Tslrs/NanoLink86/fpga_spartan3a/README.md

# Next186 SoC FreeDOS on Xilinx Spartan-3A Starter Kit

A port of the **Next186 SoC PC** (80186-compatible CPU, VGA, SD card, PS/2 keyboard, DDR2) to the
**Xilinx Spartan-3A Starter Kit (XC3S700A-4FGG484C)**. The board boots **FreeDOS 1.3** from a
microSD card and is controlled by the same **NanoLink86 ESP32 keyboard** used for the Tang Nano 9K
version, with **no change to the ESP32 firmware**.

<p align="center">
  Spartan-3A Starter Kit with the NanoLink86 ESP32 keyboard (top right) and the microSD SPI module (bottom right) on breadboards
</p>
<p align="center"><em>The Spartan-3A Starter Kit running the design. Top right: the ESP32 (NanoLink86 keyboard). Bottom right: the microSD SPI module. Both are wired to the board's 6-pin expansion headers.</em></p>

<p align="center">
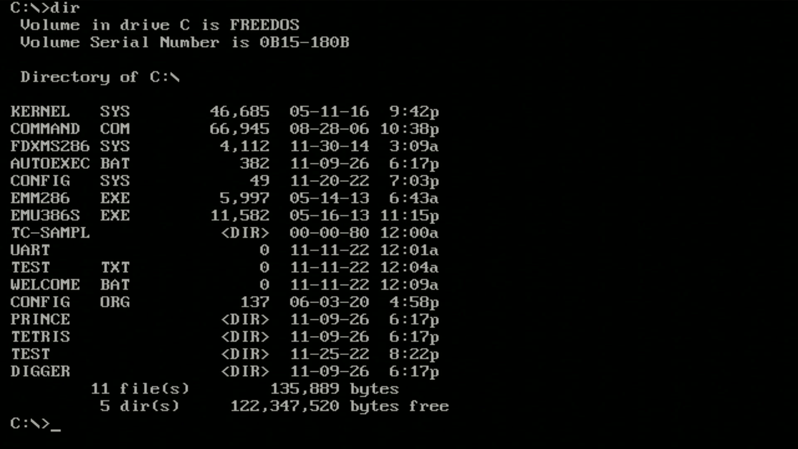
[picture p13: fpga_spartan3a/assets/spartan3a_freedos_dir.png]
FreeDOS dir listing on the Spartan-3A, captured from the VGA output
  
  Prince of Persia running on the Spartan-3A
</p>
<p align="center">
  Tetris running on the Spartan-3A
</p>

Longer videos (captured from the board's VGA output):
[Tetris](assets/videos/spartan3a_tetris_demo.mp4) and
[Prince of Persia](assets/videos/spartan3a_prince_of_persia_demo.mp4).

---

## Status

Verified on real hardware (frames captured from the board's VGA output):

| Item | Result |
| :--- | :--- |
| Boot FreeDOS 1.3 (FreeCom 0.84) from a 16 GB SDHC card | works, also after a power cycle |
| Design stored permanently in the on-board SPI flash (Atmel AT45DB161D) | works (cold-boot verified) |
| DDR2 (64 MB) memory test, 64 KB patterns | 398 passes, 0 errors |
| DOS commands from the NanoLink86 keyboard (`dir`, `echo`, `ver`, ...) | works |
| Tetris (text/graphics, colours, score) | works, controls 7/9/8/Space |
| Prince of Persia (VGA 320x200, 256 colours, arrow keys) | works |
| Digger, PS/2 mouse (second PS/2 channel) | not tested |

## Hardware

| Part | Details |
| :--- | :--- |
| Board | Digilent / Xilinx Spartan-3A Starter Kit, FPGA XC3S700A-4FGG484C (the silkscreen reads "Spartan-3A / Spartan-3AN": both kits share the same board layout, upstream targets the 3AN version) |
| CPU | Next186 (80186-compatible), clocked at 50 MHz x 4/3 = 66.7 MHz |
| Memory | 64 MB DDR2 (on-board), 8 KB BIOS RAM inside the FPGA, 8 x 256-byte cache |
| Video | 640x480 VGA, text mode and mode 13h |
| Storage | microSD in SPI mode (external SPI module, see pins below) |
| Keyboard | ESP32 NanoLink86, PS/2 clock/data (bit-banged by the ESP32) |
| Configuration | Atmel AT45DB161D SPI flash (JTAG: Platform Cable USB II) |

### Pin Assignment & Hardware Wiring

The design connects to external peripherals via the Spartan-3A Starter Kit's 6-pin expansion headers (**Pmod J18** for the microSD module and **Pmod J20** for the ESP32 keyboard).

<p align="center">
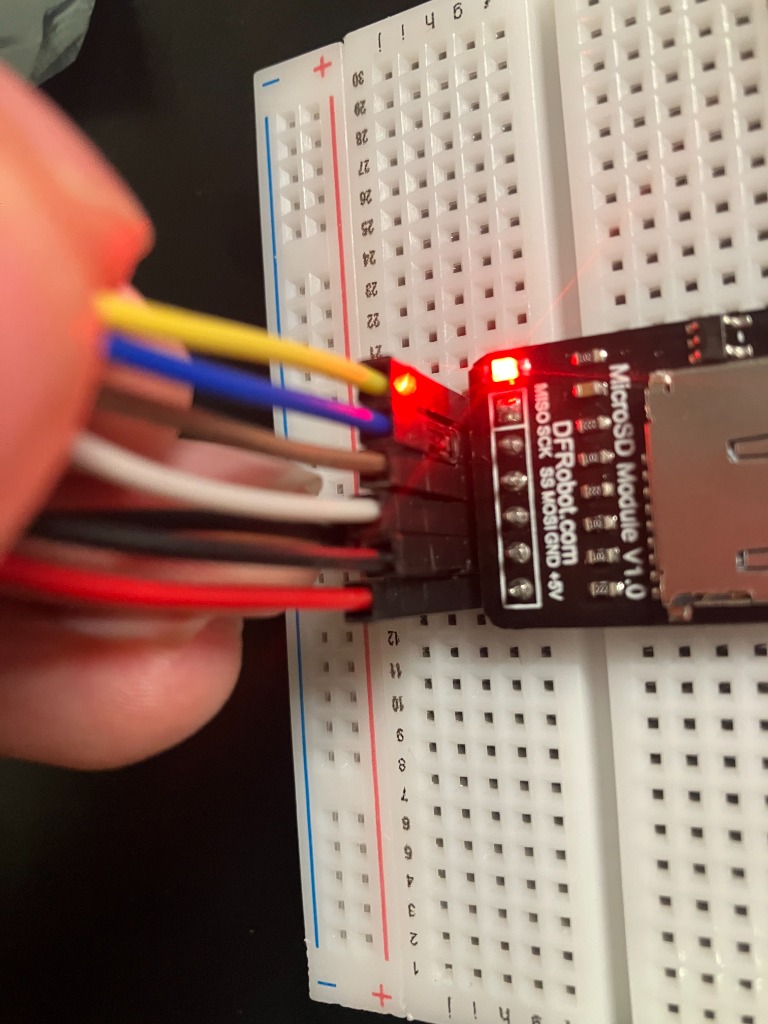
[picture p14: fpga_spartan3a/assets/spartan3a_sd_module.jpg]
DFRobot MicroSD Module V1.0 wiring
  
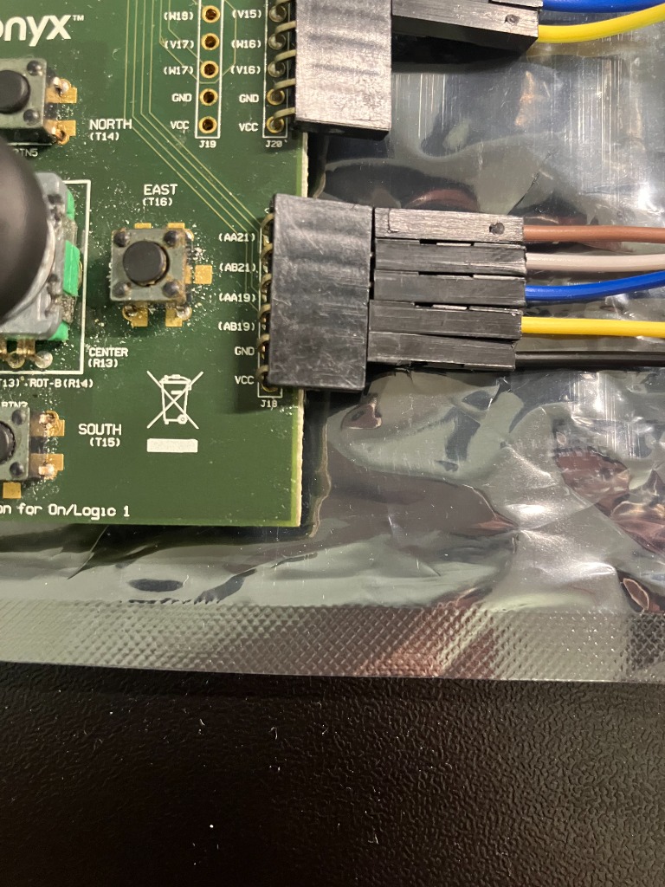
[picture p15: fpga_spartan3a/assets/spartan3a_pmod_wiring.jpg]
Spartan-3A Starter Kit Pmod J18 and J20 wiring
  
</p>
<p align="center"><em>Physical wiring: DFRobot MicroSD Module V1.0 (left) connected to Spartan-3A Pmod J18 (right), and ESP32 connected to Pmod J20.</em></p>

#### 1. MicroSD Module Wiring (Pmod J18)

The board uses an external **DFRobot MicroSD Module V1.0** operating in SPI mode connected to header **J18**:

| J18 Header Pin | FPGA Pin (`ddr_186.ucf`) | Net Name | DFRobot Module Pin | SPI Signal / Function | Reference Wire Color |
| :---: | :---: | :--- | :--- | :--- | :--- |
| **Pin 1** | `AA21` | `SD_CS` | **SS** | SPI Chip Select (Active Low) | 🟤 **Brown** |
| **Pin 2** | `AB21` | `SD_DI` | **MOSI** | Master Out / Slave In (FPGA to SD) | ⚪ **White** |
| **Pin 3** | `AA19` | `SD_CK` | **SCK** | SPI Serial Clock | 🔵 **Blue** |
| **Pin 4** | `AB19` | `SD_DO` | **MISO** | Master In / Slave Out (SD to FPGA) | 🟡 **Yellow** |
| **Pin 5** | `GND`  | `GND` | **GND** | Ground | ⚫ **Black** |
| — | — | `VCC` | **+5V** | Module Power Supply (+5V rail / VCC) | 🔴 **Red** |

> [!NOTE]
> The DFRobot MicroSD Module V1.0 includes an on-board 3.3V LDO regulator and level shifting circuitry. Connect its **+5V** pin (Red wire) to a 5V power rail (or VCC) and **GND** to common ground. When powered, the on-board red LED lights up.

#### 2. ESP32 Keyboard Connection (Pmod J20)

The ESP32 runs the exact same firmware as the Tang Nano 9K version (`esp32/main.py` or `esp32/esp32_wifi.py`). It bit-bangs PS/2 scan code set 2 directly to header **J20**:

| J20 Header Pin | FPGA Pin (`ddr_186.ucf`) | Net Name | ESP32 Pin | Function | Reference Wire Color |
| :---: | :---: | :--- | :--- | :--- | :--- |
| **Pin 1** | `V14` | `PS2_CLK1` | **GPIO 18** | Bit-banged PS/2 Clock | 🔵 **Blue** |
| **Pin 2** | `V15` | `PS2_DATA1` | **GPIO 19** | Bit-banged PS/2 Data | 🟡 **Yellow** |
| **Pin 5** | `GND` | `GND` | **GND** | Common Ground | Common GND |

The BIOS in this design expects scan code set 1, so `KB_8042.v` translates set 2 to set 1 inside the FPGA. That is why the ESP32 firmware needs zero modification.

#### 3. Other Board I/O

| Signal | FPGA Pin | Description |
| :--- | :---: | :--- |
| `PS2_CLK2` / `PS2_DATA2` | `W12` / `V11` | Second PS/2 channel (mouse), routed to the on-board female PS/2 jack |
| `sys_clk_in` / `CLK_50MHZ` | `V12` / `E12` | 133 MHz oscillator and on-board 50 MHz clock |
| `VGA_R[3:0]`, `VGA_G[3:0]`, `VGA_B[3:0]` | On-board | 12-bit DAC routed to the on-board DB15 VGA connector |
| `VGA_HSYNC` / `VGA_VSYNC` | `C11` / `B11` | VGA synchronization signals |

---

## Quick start

### 1. Prepare the SD card

Use the same FreeDOS image as the Tang Nano version (`sdcard/FDOS-128M-with-games.zip`), written
to the card. The BIOS lives inside the FPGA, so **nothing has to be written to the last 8 KB of the
card** (the upstream design needs that, this one does not).

### 2. Load the design

Temporary (lost at power-off), with Xilinx iMPACT:

```
setMode -bs
setCable -port auto
Identify -inferir
identifyMPM
assignFile -p 1 -file bitstreams/next186_spartan3a_freedos.bit
Program -p 1
quit
```

Permanent, into the SPI flash of the board (`tools`: see `bios/spi_prog.cmd`):

```
setMode -bs
setCable -port auto
Identify -inferir
identifyMPM
attachflash -position 1 -spi "AT45DB161D"
assignfiletoattachedflash -position 1 -file bitstreams/next186_spartan3a_flash_AT45DB161D.mcs
Program -p 1 -dataWidth 1 -spionly -e -v -loadfpga
quit
```

The flash is an **Atmel AT45DB161D** (JEDEC ID `1F 26 00`). Selecting another flash type (for
example `M25P16`) fails with `ID Check failed`. After programming, power-cycle the board: FreeDOS
should start by itself.

### 3. Type on it

Use the NanoLink86 web controller / relay as on the Tang Nano. For a quick test from a computer,
`tools/ws_type.py <PIN> 'dir\r'` sends text through the relay (`{LEFT}{RIGHT}{UP}{DOWN}` are
arrow keys). Known quirk: the first command typed right after a boot is sometimes corrupted; send
an Enter first.

---

## What differs from the upstream design

Upstream: <https://github.com/tmatsuya/next186_soc_pc> (commit `d59aa2b`, Spartan-3AN Starter Kit),
itself based on the Next186 SoC PC by **Nicolae Dumitrache** (OpenCores).

The CPU, the DDR2 controller, the cache, the VGA, the timers and the BIOS are **unchanged**. Changes:

1. **`src/ddr_186.v`**: BIOS RAM inside the FPGA (new `src/bios_ram.v`) instead of loading the BIOS
   from the SD card; SD card through a hardware SPI byte serializer; and a bug fix (line 440).
2. **`src/KB_8042.v`**: scan code set 2 to set 1 translation and a non-inhibited clock for the ESP32.
3. **`src/ddr_186.ucf`**: new pins for PS/2 and SD.
4. **BIOS**: 69 of 8192 bytes patched (0.8 %), applied inside the bitstream, original `.com` untouched.

Full details and the exact diffs are in [`docs/DIFF_VS_UPSTREAM.md`](docs/DIFF_VS_UPSTREAM.md) and
[`docs/patches/`](docs/patches/).

### The bug fix

The read-data mux selector for the BIOS RAM was updated on every clock:

```verilog
always @(posedge clk_cpu) bios_cs_d <= bios_cs;          // wrong
always @(posedge clk_cpu) if(CE) bios_cs_d <= bios_cs;   // fixed (ddr_186.v line 440)
```

On a cache miss the CPU is stalled (`CE = 0`), the selector moved on, and the CPU read a wrong
word. This looked like a DDR2 read-back problem for a long time; it was not (DDR2 and cache are
correct: 398 passes of a 64 KB memory test, 0 errors after the fix).

---

## Repository layout

```
fpga_spartan3a/
├── README.md
├── src/          Verilog + ISE 14.7 project (ddr_186.xise), cores, MIG DDR2, Next186 CPU
├── bios/         original BIOS, patched BIOS (8 KB), patch script, two small stubs
├── bitstreams/   ready-to-load .bit and SPI flash .mcs
├── tools/        ws_type.py (type through the relay), rec.py / cap.py (video capture)
├── docs/         DIFF_VS_UPSTREAM.md and unified diffs against upstream
└── assets/       screenshots and GIFs
```

### Building

Open `src/ddr_186.xise` in **Xilinx ISE 14.7** (device `xc3s700a`, package `fg484`, speed `-4`).
`src/bios0.hex ... bios3.hex` are generated from `bios/BIOS_Next186_spartan3a_patched.bin`
(byte lane `n` = bytes `4*i + n`), so a normal build contains the patched BIOS.
> The shipped `.bit` was produced by patching the BIOS into the BRAM initial values of an
> already placed-and-routed design (`xdl` -> `ncd` -> `bitgen`, see `bios/patch_gen.py`), which takes
> about a minute instead of a full 25-minute ISE run. A full build from `src/` has not been
> repeated with the regenerated `.hex` files.

ISE reports a small negative setup slack (about -1 ns) on the 133 MHz and 25 MHz clock domains. It
was not observed to cause problems (memory test and the games run correctly).

---

## How it was verified (capture card + Claude)

Like the Tang Nano version, the work was done in a hardware loop with an AI assistant and no lab
instruments: the board's **VGA output was plugged into a USB video capture card** (MacroSilicon
`534D:2109`), and **Claude** (Anthropic, through Claude Code) grabbed frames with OpenCV
(`tools/cap.py`), read what the FPGA was displaying, wrote a new test program in x86 assembly,
patched it into the bitstream, flashed it over JTAG, and looked at the next frame.

That loop was used to:

* run memory tests and show their result as text on screen;
* print SD card responses (CMD0/CMD8/ACMD41, OCR, CSD, partition table) as hex on screen, which
  showed a wrong BIOS patch (only the first byte of each SD command was being sent);
* confirm the FreeDOS boot, keyboard input and the games, and record the demo videos (`tools/rec.py`).

Toolchain: Xilinx ISE 14.7 inside an Ubuntu 14.04 VM (UTM on an Apple-silicon Mac), Xilinx
Platform Cable USB II, iMPACT in batch mode.

## Credits and license

* **Next186 SoC PC**: Nicolae Dumitrache (OpenCores, <http://opencores.org/project,next186>).
* **Spartan-3AN port used as the starting point**: tmatsuya (<https://github.com/tmatsuya/next186_soc_pc>).
* **NanoLink86 ESP32 keyboard and relay**: Tslrs (this repository).
* **Spartan-3A adaptation**: Tslrs, developed with AI assistance (Claude by Anthropic; an earlier
  session with another AI assistant produced the first experimental test code).

The Verilog files derived from Next186 keep their original copyright headers (GNU LGPL 2.1 or
later). Provided "as is", without warranty; wire and flash hardware at your own risk.
