Tslrs/NanoLink86/GITHUB_PROFILE_README.md

### Hi there, I'm Tslrs 👋

<p align="center">
  
</p>

```yaml
brand: Tslrs
engineer: Nikolaos Tsalaris
affiliation: Electrical & Computer Engineering, University of Western Macedonia (UOWM)
interests: [FPGA SoC Design, Embedded Systems, IoT & Telecommunications, Hardware-in-the-Loop]
location: Greece
status: Building bare-metal SoCs & open-source hardware
```

---

### 🚀 About Tslrs

- 🎓 **ECE Student** at the **University of Western Macedonia** (Kozani, Greece).
- ⚡ **FPGA & SoC Design**: Porting retro and modern x86/RISC architectures onto FPGA silicon (Xilinx Spartan-3A, Gowin Tang Nano 9K).
- 📡 **IoT & Telecommunications**: Designing long-range, low-power telemetry systems (LoRaWAN on Helium Network, ESP32, cellular IoT).
- 🔬 **Hardware-in-the-Loop & AI**: Automating silicon verification using multimodal video stream feedback and AI co-design loops.

---

### 🛠️ Tech Stack & Hardware Tools

<p align="left">
  <!-- Hardware & FPGA -->
  
  
  
  
  <br/>
  <!-- Embedded & IoT -->
  
  
  
  
  
</p>

---

### 🌟 Featured Projects

| Project | Description | Silicon / Tech |
| :--- | :--- | :--- |
| 🕹️ [**NanoLink86**](https://github.com/Tslrs/NanoLink86) | Bare-metal **FreeDOS 1.3** running on a Next186 (80186 PC) SoC. Controlled wirelessly via modern web browser & ESP32 PS/2 relay. Cross-ported to **Gowin Tang Nano 9K** and **Xilinx Spartan-3A Starter Kit** with DDR2 memory and SPI MicroSD storage. | `Verilog` `x86 SoC` `DDR2` `ESP32` `FreeDOS` |
| 🌊 [**River-Monitor-LoRaWAN**](https://github.com/Tslrs/River-Monitor-LoRaWAN-Showcase) | Solar-ready IoT river monitoring station with real-time telemetry over the **LoRaWAN Helium Network** and cloud dashboard integration. | `ESP32` `LoRaWAN` `Helium` `Low-Power` |

---

### 📊 GitHub Activity & Stats

<p align="center">
  
  
</p>

---

<p align="center">
  <em><strong>Tslrs</strong> · Building bridging systems between physical silicon and the modern web.</em>
</p>
