Tslrs/NanoLink86/PROPOSAL_PITCH_DASYGENIS.txt

================================================================================
          ΠΡΟΤΑΣΗ ΚΑΙΝΟΤΟΜΙΑΣ ΓΙΑ ΣΥΝΑΝΤΗΣΗ ΜΕ ΤΟΝ ΚΑΘΗΓΗΤΗ Μ. ΔΑΣΥΓΕΝΗ
     "Next-Gen AI-Driven Universal Toolchain for FPGA Synthesis & Programming"
================================================================================
Φοιτητής: Νικόλαος Τσαλάρης (Τμήμα ΗΜΜΥ, ΠΔΜ, ΑΜ: 2452)
Ημερομηνία Συνάντησης: Δευτέρα 16/11 ή 23/11 στις 17:00
Αποθετήριο Project: https://github.com/Tslrs/NanoLink86
================================================================================

1. Ο ΤΙΤΛΟΣ & ΤΟ ΟΡΑΜΑ ΤΗΣ ΠΡΟΤΑΣΗΣ
--------------------------------------------------------------------------------
"Εκσυγχρονισμός και Αυτοματοποίηση της Ροής Σύνθεσης & Προγραμματισμού Ετερογενών
FPGA (Xilinx/Gowin) μέσω Headless Αρχιτεκτονικής και AI Hardware-in-the-Loop"

Στόχος: Να μετατρέψουμε την πιο επίπονη διαδικασία των FPGA (βαριά εργαλεία 30GB,
αποτυχημένοι proprietary programmers, χειροκίνητο debugging) σε μια ταχύτατη,
αυτοματοποιημένη ροή που ελέγχεται ακόμα και μέσω φυσικής γλώσσας (AI Agents).

2. ΤΑ 3 ΠΡΑΓΜΑΤΙΚΑ ΠΡΟΒΛΗΜΑΤΑ ΠΟΥ ΛΥΝΟΥΜΕ (THE BOTTLENECK)
--------------------------------------------------------------------------------
1. Το Πρόβλημα της Σύνθεσης (Synthesis Bloat):
   - Εργαλεία όπως το Xilinx ISE 14.7 είναι κλειδωμένα σε λειτουργικά του 2012
     (Ubuntu 14.04 / Win7), απαιτώντας τεράστια Virtual Machines 20-30 GB.
   - Σε σύγχρονα Mac (Apple Silicon ARM64) ή νέα laptops, η εκτέλεση είναι αργή
     και μη παραγωγική.

2. Το Πρόβλημα του Προγραμματισμού (Proprietary JTAG Lock-in):
   - Οι επίσημοι προγραμματιστές (όπως ο Xilinx Platform Cable USB) βασίζονται
     σε κλειστούς kernel drivers και δυναμικό re-enumeration του Cypress FX2 chip,
     που αποτυγχάνει συστηματικά σε USB passthrough σε VMs.

3. Το Πρόβλημα της Επαλήθευσης (Manual Hardware Debugging):
   - Για να δει ο μηχανικός αν δουλεύει ένα SoC στο FPGA, κάθεται με τις ώρες μπροστά
     σε οθόνες, πληκτρολόγια και παλμογράφους δοκιμάζοντας χειροκίνητα.

3. ΟΙ 3 ΠΥΛΩΝΕΣ ΤΗΣ ΚΑΙΝΟΤΟΜΙΑΣ ΜΑΣ (Η ΛΥΣΗ)
--------------------------------------------------------------------------------

ΠΥΛΩΝΑΣ Α: ΚΑΙΝΟΤΟΜΙΑ ΣΤΟ SYNTHESIS (Headless & BRAM Instant Patching)
---------------------------------------------------------------------
* Αντί για βαριά γραφικά περιβάλλοντα (GUIs), η σύνθεση διαχωρίζεται:
  α) Remote Headless Build Server (στον server του εργαστηρίου):
     Ο φοιτητής γράφει Verilog στο laptop του (VS Code / AI). Με ένα click ή εντολή,
     το project στέλνεται στον build server, συντίθεται αθόρυβα μέσω CLI scripts
     (xst, map, par, bitgen) και επιστρέφει το έτοιμο .bit σε 2 λεπτά!
  β) Native Open-Source Synthesis (για νέα FPGA όπως Tang Nano 9K / Gowin):
     Εκτέλεση Yosys + nextpnr 100% native στο Mac/Linux σε δευτερόλεπτα.
  γ) Instant BRAM Patching (Το δικό μας μυστικό):
     Όταν αλλάζει κώδικας λογισμικού, BIOS ή microcode, δεν περιμένουμε 25 λεπτά
     για σύνθεση! Ένα script ενημερώνει απευθείας τα Block RAM initial values του
     bitstream σε 0.5 δευτερόλεπτο!

ΠΥΛΩΝΑΣ Β: ΚΑΙΝΟΤΟΜΙΑ ΣΤΟ PROGRAMMING (Universal Native Open-JTAG)
-----------------------------------------------------------------
* Καταργούμε την εξάρτηση από τους προβληματικούς proprietary programmers:
  α) Χρησιμοποιούμε Universal Open-Source εργαλεία (openFPGALoader, xc3sprog)
     που τρέχουν απευθείας σε macOS και Linux χωρίς κανένα driver πυρήνα.
  β) Universal Hardware: Χρήση φθηνών FTDI interfaces (FT2232H / Digilent HS2)
     ή ενός Raspberry Pi Pico ($4) με DirtyJTAG.
  γ) Μία ενιαία εντολή προγραμματίζει τόσο το σύγχρονο Gowin Tang Nano 9K όσο
     και την κλασική Xilinx Spartan-3A και τη μόνιμη SPI Flash!

ΠΥΛΩΝΑΣ Γ: ΤΟ ΑΠΟΛΥΤΟ HIT -> AI HARDWARE-IN-THE-LOOP (MCP & Video Feedback)
---------------------------------------------------------------------------
* Universal FPGA MCP Server (Model Context Protocol):
  Συνδέουμε το physical hardware με AI Agents (όπως Claude, Antigravity):
  - Το AI μπορεί να εκτελέσει: detect_hardware(), program_sram(), program_flash().
* Automated Video Closed Loop:
  - Η έξοδος VGA του FPGA συνδέεται σε USB capture card.
  - Το AI διαβάζει τα frames (OCR / frame inspection), εντοπίζει αν το memory test
    πέρασε ή αν το FreeDOS μπούταρε, γράφει assembly διορθώσεις και ξαναφορτώνει
    το bitstream αυτόματα!
  - Πλήρως αυτόνομη επαλήθευση υλικού (Autonomous Hardware Verification).

4. ΤΙ ΝΑ ΠΕΙΣ ΛΕΞΗ ΠΡΟΣ ΛΕΞΗ ΣΤΟΝ ΚΑΘΗΓΗΤΗ (ΣΧΕΔΙΟ ΣΥΖΗΤΗΣΗΣ)
--------------------------------------------------------------------------------

[Βήμα 1: Ευχαριστίες & Εισαγωγή (1 λεπτό)]
"Κύριε καθηγητά, σας ευχαριστώ πολύ για την πρόσκληση και τα θετικά σας σχόλια για
το project NanoLink86. Η πρότασή σας για ερευνητική συνεργασία με τιμάει ιδιαίτερα
και με ενδιαφέρει απόλυτα."

[Βήμα 2: Τι αποδείξαμε στην πράξη με το NanoLink86 (2 λεπτά)]
"Στο project καταφέραμε να τρέξουμε ένα πλήρες x86 PC SoC (Next186 με FreeDOS 1.3,
DDR2, VGA, SPI MicroSD) σε δύο ριζικά διαφορετικές πλακέτες: στο σύγχρονο Gowin
Tang Nano 9K και στη Xilinx Spartan-3A. Επιπλέον, συνδέσαμε ένα ESP32 gateway
για ασύρματο έλεγχο από web browser, τρέχοντας ακόμα και live audio player στο DOS."

[Βήμα 3: Το πρόβλημα που εντοπίσαμε & Η πρόταση καινοτομίας (3 λεπτά)]
"Κατά την ανάπτυξη στη Spartan-3A, παρατήρησα πόσο μεγάλο πρόβλημα υπάρχει με τα
παλιά εργαλεία: τα βαριά VMs των 30GB για το ISE 14.7 και οι proprietary drivers
του Xilinx Platform Cable που δεν παίζουν σε σύγχρονα Mac και νέα Linux συστήματα.

Αυτό με οδήγησε να σκεφτώ μια καινοτόμο ερευνητική πρόταση:
Να φτιάξουμε ένα σύγχρονο, ελαφρύ και έξυπνο οικοσύστημα για το εργαστήριο:
1. Στο Programming: Χρήση open-source native εργαλείων (openFPGALoader με FTDI/Pico)
   που προγραμματίζουν άμεσα και Gowin και Xilinx από Mac/Linux χωρίς VM.
2. Στο Synthesis: Headless build pipeline (μέσω Docker ή απομακρυσμένου server του
   εργαστηρίου) σε συνδυασμό με BRAM instant patching σε μισό δευτερόλεπτο.
3. Στο AI Verification: Έναν Universal FPGA MCP Server όπου ένα AI agent, μέσω
   μιας απλής capture card, ελέγχει την οθόνη του FPGA, εντοπίζει bugs και δοκιμάζει
   αυτόματα νέα bitstreams (Hardware-in-the-Loop)."

[Βήμα 4: Το ερευνητικό αποτέλεσμα & Δημοσίευση (1-2 λεπτά)]
"Πιστεύω ότι αυτή η προσέγγιση —ο συνδυασμός AI-driven Verification και Universal
Hardware Toolchain— έχει εξαιρετικές πιθανότητες για δημοσίευση σε συνέδριο
(π.χ. MOCAST, DSD ή PCI) και μπορεί να αναβαθμίσει σημαντικά και τα εργαστηριακά
μαθήματα της σχολής. 
Ποια είναι η δική σας οπτική και πώς θα μπορούσαμε να το προχωρήσουμε μαζί με την
ερευνητική ομάδα του εργαστηρίου;"

5. ΠΙΘΑΝΟΙ ΤΙΤΛΟΙ ΓΙΑ ΕΠΙΣΤΗΜΟΝΙΚΟ PAPER
--------------------------------------------------------------------------------
1. "A Zero-Intrusive IoT Hardware Gateway for Real-Time Remote Control and Telemetry
   of Legacy Embedded x86 SoCs on FPGA"
2. "Autonomous Hardware-in-the-Loop Verification for FPGA SoCs Using Multimodal AI
   and Direct Video Feedback"
3. "A Lightweight, Cross-Vendor Synthesis and In-System Programming Framework for
   Heterogeneous FPGA Educational Labs"

6. ΣΥΜΒΟΥΛΕΣ ΓΙΑ ΤΗ ΣΥΝΑΝΤΗΣΗ
--------------------------------------------------------------------------------
* Να έχεις αυτοπεποίθηση: Έχεις καταφέρει κάτι που λίγοι προπτυχιακοί φοιτητές
  πετυχαίνουν (δύο λειτουργικά SoC σε πραγματικό silicon, άριστο GitHub repository).
* Έχε μαζί σου το laptop: Αν σου ζητήσει να δει κάτι, άνοιξε το GitHub repo
  (https://github.com/Tslrs/NanoLink86) και δείξε του τα βίντεο και τα διαγράμματα.
* Άκουσε προσεκτικά: Αφού του κάνεις το pitch, άφησέ τον να σου πει τα δικά του
  ερευνητικά πλάνα και δες πού κουμπώνουν ιδανικά με τις δικές σου ικανότητες!
================================================================================
