Tslrs/NanoLink86/assets/card_intenso_16gb.png

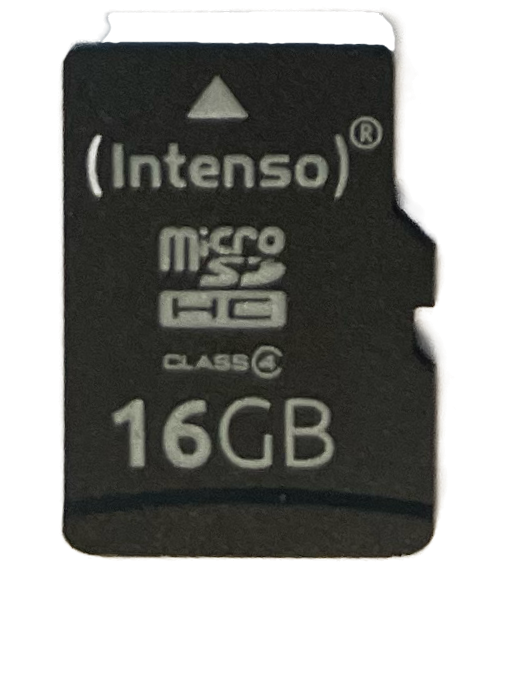
assets/card_intenso_16gb.png
