Tslrs/NanoLink86/assets/card_kingston_4gb.png

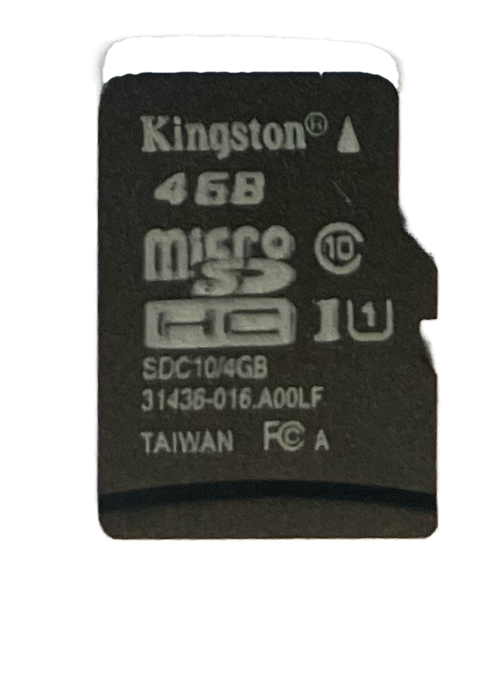
assets/card_kingston_4gb.png
