Tslrs/NanoLink86/assets/card_kingston_16gb.png

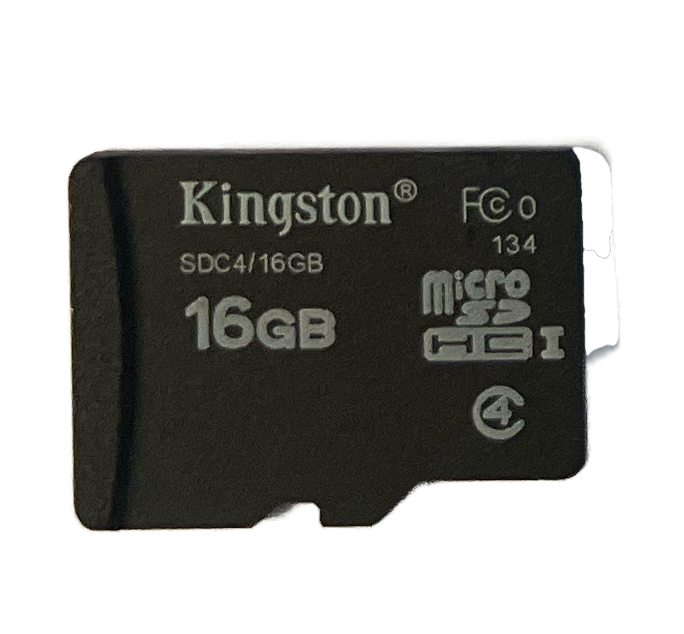
assets/card_kingston_16gb.png
