Tslrs/NanoLink86/assets/microsd_compatibility_matrix.jpg

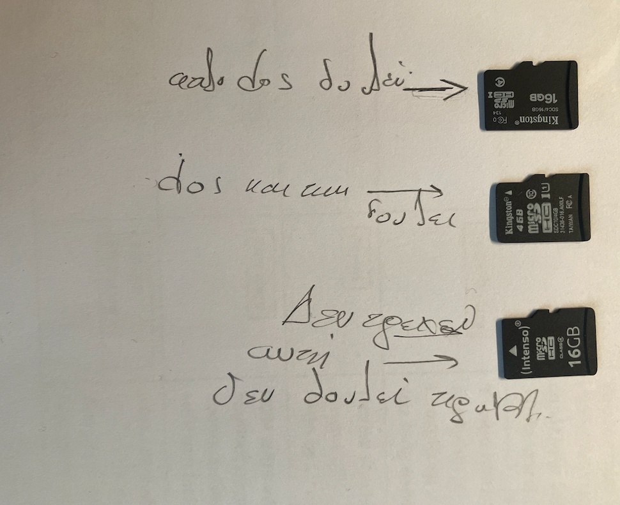
assets/microsd_compatibility_matrix.jpg
