Tslrs/NanoLink86/assets/tang_nano_9k_board.png

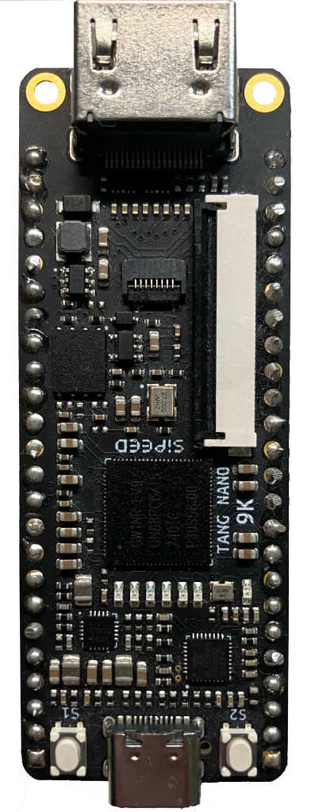
assets/tang_nano_9k_board.png
