Tslrs/NanoLink86/(list of files, cad)

Other CAD files:
fpga/BIOS/BIOS_Next186.obj
fpga/BOOT/bootstrap.obj
