Tslrs/NanoLink86/fpga_spartan3a/src/dcm_cpu.v

////////////////////////////////////////////////////////////////////////////////
// Copyright (c) 1995-2013 Xilinx, Inc.  All rights reserved.
////////////////////////////////////////////////////////////////////////////////
//   ____  ____ 
//  /   /\/   / 
// /___/  \  /    Vendor: Xilinx 
// \   \   \/     Version : 14.7
//  \   \         Application : xaw2verilog
//  /   /         Filename : dcm_cpu.v
// /___/   /\     Timestamp : 11/09/2026 09:19:26
// \   \  /  \ 
//  \___\/\___\ 
//
//Command: xaw2verilog -intstyle /home/ubuntu/Desktop/spartan3a_next186/ipcore_dir/dcm_cpu.xaw -st dcm_cpu.v
//Design Name: dcm_cpu
//Device: xc3s700an-4fgg484
//
// Module dcm_cpu
// Generated by Xilinx Architecture Wizard
// Written for synthesis tool: XST
// Period Jitter (unit interval) for block DCM_SP_INST = 0.05 UI
// Period Jitter (Peak-to-Peak) for block DCM_SP_INST = 0.79 ns
`timescale 1ns / 1ps

module dcm_cpu(CLKIN_IN, 
               CLKDV_OUT, 
               CLKFX_OUT, 
               CLKIN_IBUFG_OUT, 
               CLK0_OUT, 
               CLK2X_OUT);

    input CLKIN_IN;
   output CLKDV_OUT;
   output CLKFX_OUT;
   output CLKIN_IBUFG_OUT;
   output CLK0_OUT;
   output CLK2X_OUT;
   
   wire CLKDV_BUF;
   wire CLKFB_IN;
   wire CLKFX_BUF;
   wire CLKIN_IBUFG;
   wire CLK0_BUF;
   wire CLK2X_BUF;
   wire GND_BIT;
   
   assign GND_BIT = 0;
   assign CLKIN_IBUFG_OUT = CLKIN_IBUFG;
   assign CLK0_OUT = CLKFB_IN;
   BUFG  CLKDV_BUFG_INST (.I(CLKDV_BUF), 
                         .O(CLKDV_OUT));
   BUFG  CLKFX_BUFG_INST (.I(CLKFX_BUF), 
                         .O(CLKFX_OUT));
   IBUFG  CLKIN_IBUFG_INST (.I(CLKIN_IN), 
                           .O(CLKIN_IBUFG));
   BUFG  CLK0_BUFG_INST (.I(CLK0_BUF), 
                        .O(CLKFB_IN));
   BUFG  CLK2X_BUFG_INST (.I(CLK2X_BUF), 
                         .O(CLK2X_OUT));
   DCM_SP #( .CLK_FEEDBACK("1X"), .CLKDV_DIVIDE(2.0), .CLKFX_DIVIDE(3), 
         .CLKFX_MULTIPLY(4), .CLKIN_DIVIDE_BY_2("FALSE"), 
         .CLKIN_PERIOD(20.000), .CLKOUT_PHASE_SHIFT("NONE"), 
         .DESKEW_ADJUST("SYSTEM_SYNCHRONOUS"), .DFS_FREQUENCY_MODE("LOW"), 
         .DLL_FREQUENCY_MODE("LOW"), .DUTY_CYCLE_CORRECTION("FALSE"), 
         .FACTORY_JF(16'hC080), .PHASE_SHIFT(0), .STARTUP_WAIT("FALSE") ) 
         DCM_SP_INST (.CLKFB(CLKFB_IN), 
                       .CLKIN(CLKIN_IBUFG), 
                       .DSSEN(GND_BIT), 
                       .PSCLK(GND_BIT), 
                       .PSEN(GND_BIT), 
                       .PSINCDEC(GND_BIT), 
                       .RST(GND_BIT), 
                       .CLKDV(CLKDV_BUF), 
                       .CLKFX(CLKFX_BUF), 
                       .CLKFX180(), 
                       .CLK0(CLK0_BUF), 
                       .CLK2X(CLK2X_BUF), 
                       .CLK2X180(), 
                       .CLK90(), 
                       .CLK180(), 
                       .CLK270(), 
                       .LOCKED(), 
                       .PSDONE(), 
                       .STATUS());
endmodule
