Tslrs/NanoLink86/(commit log)

2026-10-24 Direct dual-button layout for USB Serial and Bluetooth BLE
2026-10-24 Include complete Gowin FPGA source tree, BIOS/BOOT sources, kyo-ta04/hi631 credits, and Raspberry Pi Imager guide
    [BIOS_Next186.obj, bootstrap.obj]
2026-10-24 Add MIT License, power consumption report, and neutral wiring pinout
2026-10-24 Organize building and debugging story into 3 clear bullets (SD Card, Video Capture, ESP32 Co-Processor)
2026-10-29 Add NanoLink86 precision WiFi telemetry relay, captive portal & audit dashboard
2026-10-29 Translate relay README and comments to 100% English
2026-10-29 Remove hardcoded recovery PIN, document config file PIN recovery & BLE vs WiFi coexistence
2026-10-29 Update master README: add Wi-Fi relay & 3-way controller highlights, remove ESP power row
2026-11-01 Clarify Prince of Persia as an intentional static framebuffer and color palette benchmark
2026-11-01 docs: add MicroSD physical compatibility matrix and SPI fallback analysis
2026-11-01 docs: add physical Tang Nano 9K board studio photograph
2026-11-01 docs: add real physical breadboard testbed photograph with wiring
2026-11-01 docs: clean up FPGA utilization section, retain breadboard wiring setup
2026-11-07 feat: add native 80186 live music visualizer, settings toggle and telemetry relay
2026-11-10 Add Spartan-3A Starter Kit port (Next186 SoC, FreeDOS, ESP32 keyboard)
2026-11-12 docs(spartan3a): add hardware wiring guide and photos for microSD and ESP32
2026-11-13 docs: add research proposal pitch guide for Prof. Dasygenis meeting
2026-11-13 feat(hardware): add Claude Desktop hardware spec for next-gen multi-radio IoT board
