Tslrs/NanoLink86/(notices)

Notices in the files:
fpga/src/vga.v:
Public License along with this source; if not, download it
from http://www.opencores.org/lgpl.shtml
